TobleMiner/VFDboy-advance/button-daughterboard/ab-daughterboard.step

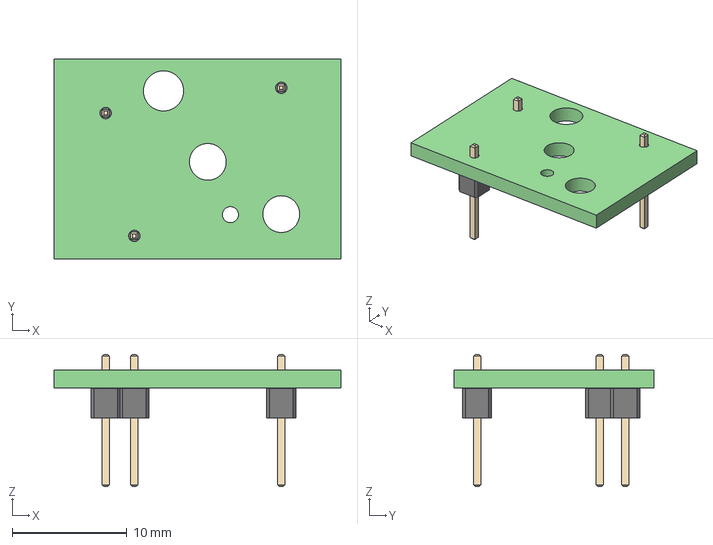
[picture p1: CAD file, 2021-01-19]
button-daughterboard/ab-daughterboard.step
25.0 x 17.4 x 11.5 mm
