TobleMiner/VFDboy-advance/LiPo_6060100.step

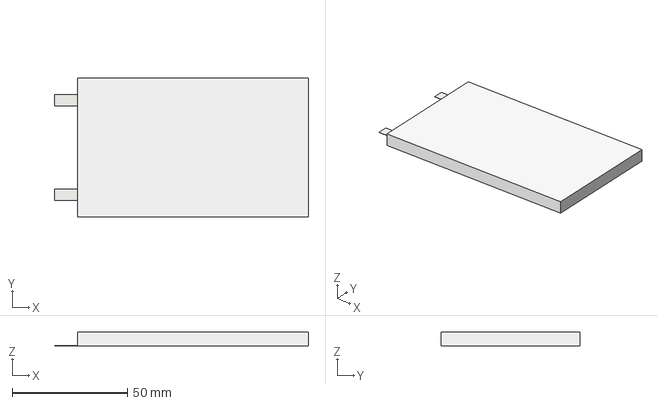
[picture p2: CAD file, 2021-01-10]
LiPo_6060100.step
110.0 x 60.0 x 6.00 mm
