TobleMiner/VFDboy-advance/button-daughterboard/dpad-daughterboard.step

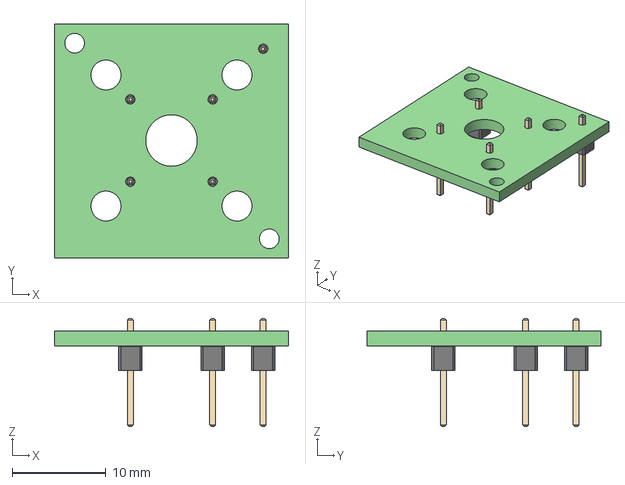
[picture p3: CAD file, 2021-01-17]
button-daughterboard/dpad-daughterboard.step
25.0 x 25.0 x 11.5 mm
