TobleMiner/VFDboy-advance/button-daughterboard/button-daughterboard.kicad_pcb

## KiCad design button-daughterboard/button-daughterboard.kicad_pcb (2021-01-19)

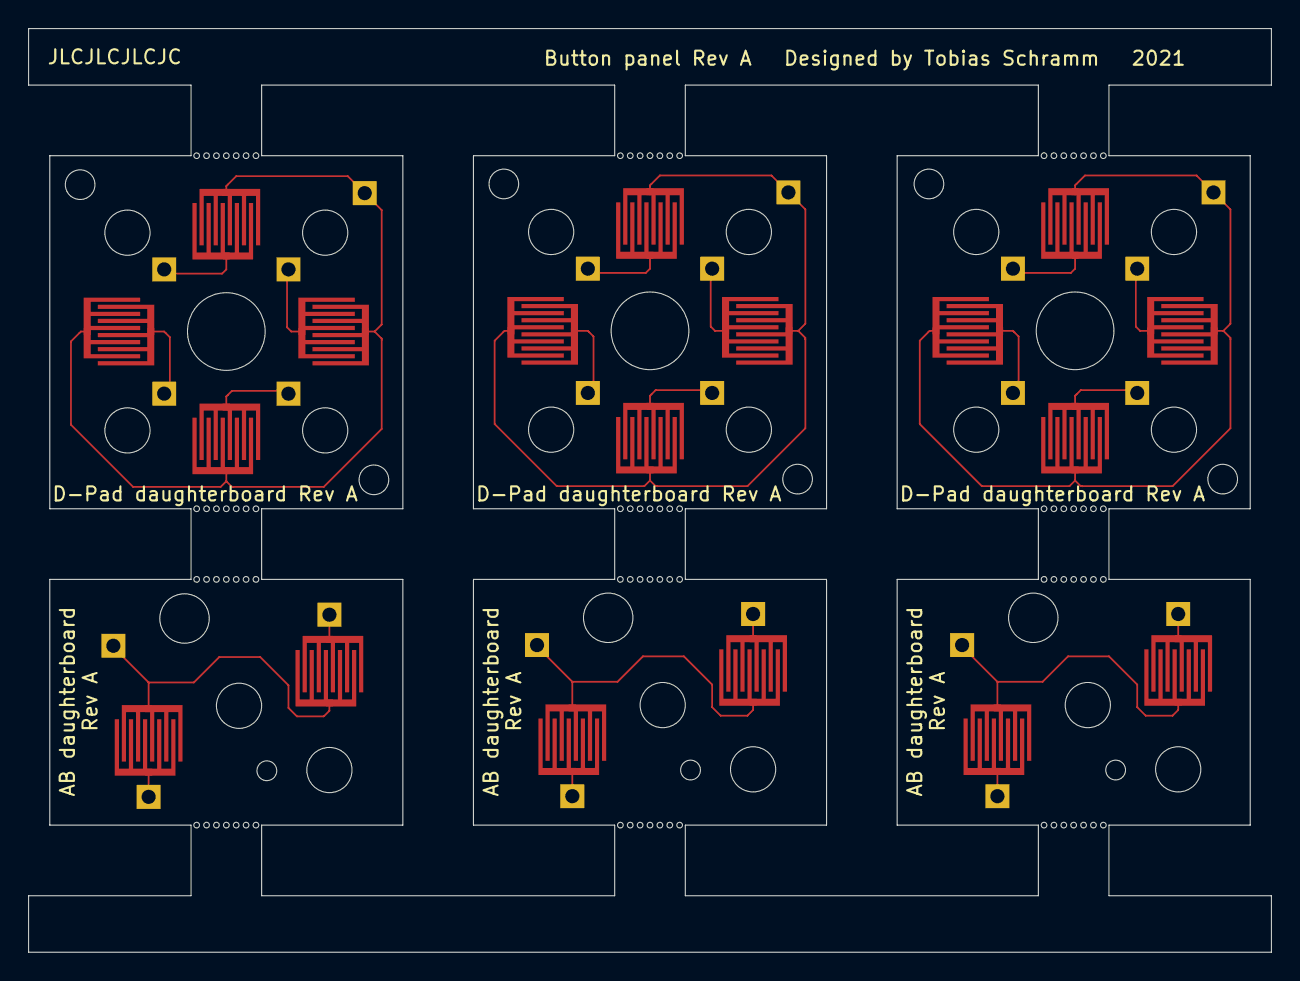
[picture p27: board button-daughterboard.kicad_pcb from above]

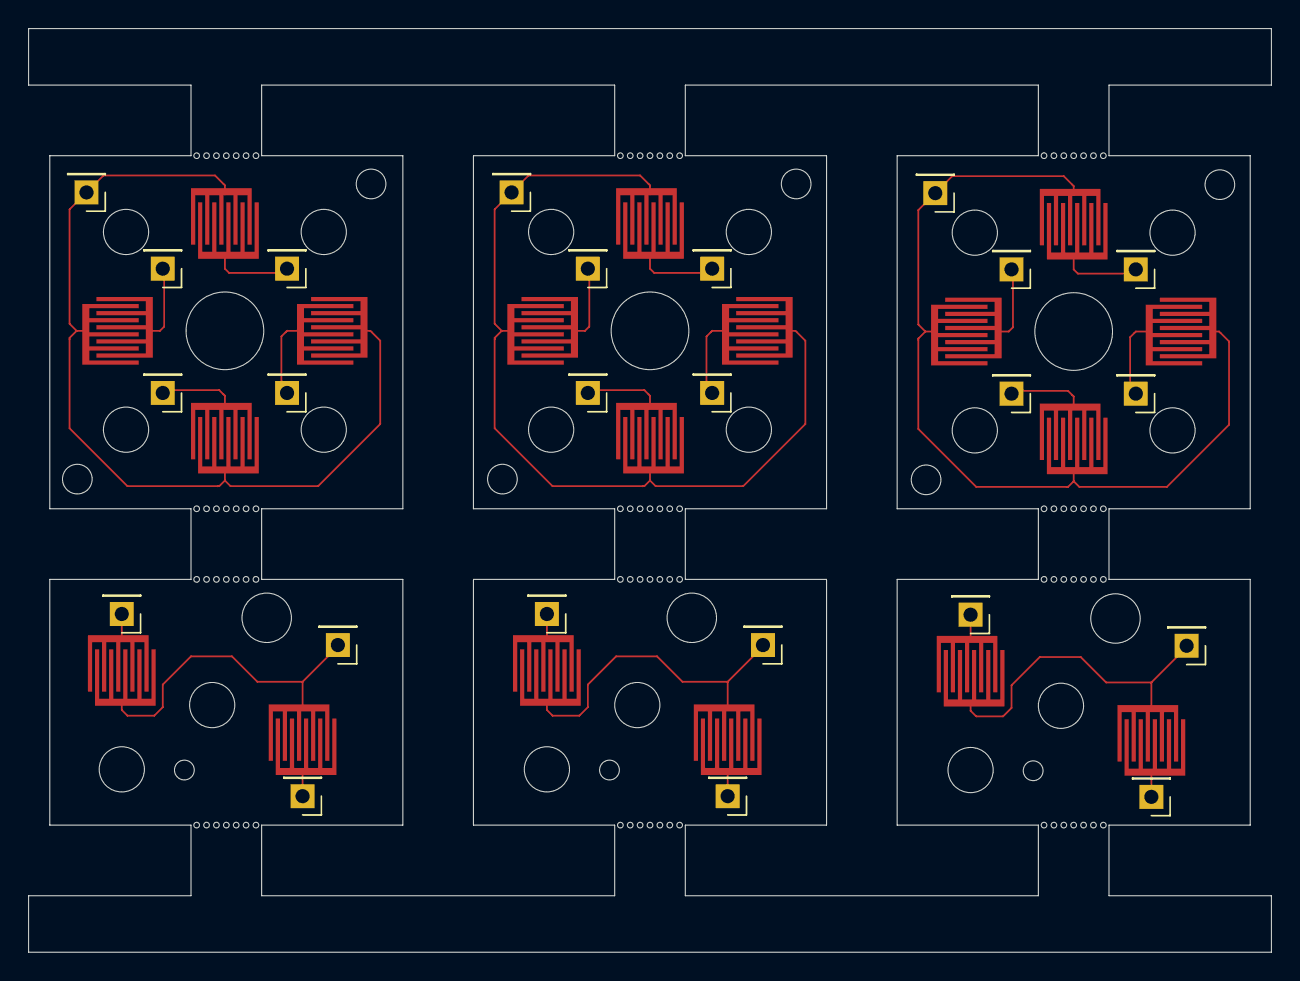
[picture p28: board button-daughterboard.kicad_pcb from below]

Board: 2 copper layers, 88.0 x 65.4 mm, 75 parts (24 on the bottom side), 19 nets.

Parts:
H1, H12, H23: D-Pad Hole; MountingHole_5.5mm
H2, H13, H24: D-Pad top left; MountingHole_GameBoy_DPAD
H3, H14, H25: D-Pad bottom right; MountingHole_GameBoy_DPAD
H4, H5, H6, H7, H10, H11, H15, H16, H17, H18, H21, H22, H26, H27, H28, H29, H32, H33: MountingHole; MountingHole_3.2mm_M3
H8, H19, H30: AB top left; MountingHole_3.5mm
H9, H20, H31: AB bottom right; MountingHole_GBA_AB_bottom_right
J1, J2, J3, J4, J5, J6, J7, J8, J9, J10, J11, J12, J13, J14, J15, J16, J17, J18, J19, J20, J21, J22, J23, J24: Conn_01x01; PinHeader_1x01_P2.54mm_Vertical
SW1, SW2, SW3, SW4, SW5, SW6, SW7, SW8, SW9, SW10, SW11, SW12, SW13, SW14, SW15, SW16, SW17, SW18: SW_Push; Button_Carbon_5mm

Connections:
GND: J5.1, J7.1, J13.1, J16.1, J21.1, J24.1, SW1.2, SW2.2, SW3.2, SW4.2, SW5.2, SW6.2, SW7.2, SW8.2, SW9.2, SW10.2, SW11.2, SW12.2, SW13.2, SW14.2, SW15.2, SW16.2, SW17.2, SW18.2
unnamed: J1.1, SW1.1
unnamed: J2.1, SW2.1
unnamed: J3.1, SW3.1
unnamed: J4.1, SW4.1
unnamed: J6.1, SW5.1
unnamed: J8.1, SW6.1
unnamed: J9.1, SW7.1
unnamed: J10.1, SW8.1
unnamed: J11.1, SW9.1
unnamed: J12.1, SW10.1
unnamed: J14.1, SW11.1
unnamed: J15.1, SW12.1
unnamed: J17.1, SW13.1
unnamed: J18.1, SW14.1
unnamed: J19.1, SW15.1
unnamed: J20.1, SW16.1
unnamed: J22.1, SW17.1
unnamed: J23.1, SW18.1
