TobleMiner/VFDboy-advance/(commit log)

2021-01-08 Add self-programming capability
    [STM.sch, VFDboy.sch, power.sch, power_switch.sch]
2021-01-08 Add charge state/current sensing and VBUS wakeup source
    [STM.sch, VFDboy.kicad_pcb, VFDboy.sch, power.sch]
2021-01-08 Implement fuel gauging
    [STM.sch, VFDboy.kicad_pcb, VFDboy.sch, power.sch]
2021-01-08 Partially routed
    [VFDboy.kicad_pcb]
2021-01-08 route VFD power
    [VFDboy.kicad_pcb]
2021-01-09 Finish layout
    [STM.sch, VFDboy.kicad_pcb, VFDboy.sch, power.sch]
2021-01-09 Add additional mounting holes
    [VFDboy.kicad_pcb, VFDboy.sch, power.sch]
2021-01-10 Add VFD 3D model
    [VFDboy.kicad_pcb]
2021-01-10 Add last 3d models
    [VFDboy.kicad_pcb]
2021-01-10 Hide silkscreen designators
    [VFDboy.kicad_pcb]
2021-01-10 Add 6060100 and 606090 LiPo footprints
2021-01-10 Replace test points by battery footprints
    [VFDboy.kicad_pcb, power.sch]
2021-01-10 Route SD interface
    [LiPo_6060100.step, STM.sch, VFDboy.kicad_pcb, VFDboy.sch, power.sch]
2021-01-10 Hookup VFD
    [STM.sch, VFDboy.kicad_pcb]
2021-01-11 Connect buttons
    [STM.sch, VFDboy.kicad_pcb, VFDboy.sch]
2021-01-11 Route VBUS
    [VFDboy.kicad_pcb]
2021-01-11 Route charger controls
    [VFDboy.kicad_pcb]
2021-01-11 route RGB LED
    [STM.sch, VFDboy.kicad_pcb]
2021-01-16 Add GBA dpad mounting holes
2021-01-16 Add support for GBA D-Pad mounting
    [STM.sch, VFDboy.kicad_pcb, VFDboy.sch, led.sch, leds.sch, power.sch, power_switch.sch]
2021-01-16 Add Game Boy compatible D-Pad mounting holes
    [VFDboy.kicad_pcb, VFDboy.sch]
2021-01-16 Add AB button mounting
    [VFDboy.kicad_pcb, VFDboy.sch]
2021-01-16 Fix rubber mounting mechanicals
    Hole spacings were off by quite a bit
    [VFDboy.kicad_pcb]
2021-01-16 Add tooling holes
    [VFDboy.kicad_pcb, VFDboy.sch]
2021-01-16 Add Pin 1 markers
    [VFDboy.kicad_pcb]
2021-01-16 Add TVS diode pin 1 marker
    [VFDboy.kicad_pcb]
2021-01-16 Place and route WS2812 LEDs
    [STM.sch, VFDboy.kicad_pcb, VFDboy.sch, led.sch, leds.sch, power.sch, power_switch.sch]
2021-01-16 Perform via stitching
    [VFDboy.kicad_pcb]
2021-01-16 Hide all silkscreen reference designators
    [VFDboy.kicad_pcb]
2021-01-17 Add D-Pad daugtherboard
    [ab.sch, button-daughterboard.kicad_pcb, button-daughterboard.sch, buttons.sch, dpad.sch]
2021-01-17 Add D-Pad 3d model
    [button-daughterboard.kicad_pcb, dpad-daughterboard.step]
2021-01-17 Add D-Pad footprint
2021-01-17 Add option for elevated D-Pad
    [VFDboy.kicad_pcb, VFDboy.sch, button-daughterboard.kicad_pcb, dpad-daughterboard.step, led.sch]
2021-01-17 Hide silkscreen reference designators
    [VFDboy.kicad_pcb]
2021-01-18 Add AB buttons
    [ab.sch, button-daughterboard.kicad_pcb, dpad.sch]
2021-01-18 Implement elevated AB surfaces
    [STM.sch, VFDboy.kicad_pcb, VFDboy.sch, ab-daughterboard.step, button-daughterboard.kicad_pcb, led.sch]
2021-01-18 Add some margin left of B button
    [ab-daughterboard.step, button-daughterboard.kicad_pcb]
2021-01-19 Panelize button daughterboards
    [ab-daughterboard.step, ab.sch, button-daughterboard.kicad_pcb, button-daughterboard.sch, dpad.sch]
2021-01-19 Use tactile power switch
    [STM.sch, VFDboy.kicad_pcb, VFDboy.sch]
2021-01-19 Reduce paste coverage on QFN and DFN thermal pads
    [VFDboy.kicad_pcb, VFDboy.sch, power.sch]
2021-01-19 Fix LCSC partnumbers
    [STM.sch, VFDboy.kicad_pcb]
2021-01-19 Remove large name
    JLCPCB does not support black solder resist + ENIG for assembly
    [VFDboy.kicad_pcb]
2021-01-19 Add schematic export
    [VFDboy.sch, led.sch]
